dalaofei1154/codex-rotating-flower/hardware/README.md

# 雏菊模型与打印文件

一朵花需要 **10 个打印件**。这里提供 9 个 3MF 打印工程、13 个分色 STL 和 10 个可编辑 Blender 网格文件。

- [按图选择模型](daisy-light/VISUAL_GUIDE.md)
- [打印说明](daisy-light/README.md) · [English printing guide](daisy-light/README.en.md)
- [图解制作教程](../docs/diy-guide/README.md) · [English build guide](../docs/diy-guide/README.en.md)
- [零件与文件清单](daisy-light/manifest.json)

我现在的实物使用 L2 带灯盆盖和 P4 透明灯帽，转动、亮灯都正常。花心、灯帽和枝干与盆盖的连接还有些松，后续会继续改进；搬动时托住花盆。

模型采用 [CC BY-NC-SA 4.0](LICENSE.md)，可署名后非商业使用、修改，并以相同许可分享。
