dalaofei1154/codex-rotating-flower/hardware/daisy-light/README.md

# 雏菊带灯版 · 打印与可编辑模型

**简体中文** · [English](README.en.md) · [按图选择模型](VISUAL_GUIDE.md)

一套需要 **10 个打印件**，使用 L2 带灯旋扣盖和 P4 透明灯帽。文件包括 9 个 3MF 打印工程、13 个分色 STL 和 10 个 Blender 网格文件。

## 打印前

在 Bambu Studio 中选择“打开项目”，载入 `print/` 里的 3MF，再选择自己的打印机、喷嘴和耗材重新切片。检查逐层预览后打印。

- `P02.3mf` 含电机后盖和藏线盖，各用 1 件。
- `P06_2pcs.3mf` 含 2 个盆盖，一朵花只用 1 个。
- `P09_4pcs.3mf` 含 4 个灯帽，一朵花只用 1 个。

全部照原盘打印会得到 14 件，多出 1 个盆盖和 3 个灯帽。按需调整数量，保留原尺寸。3MF 中的料槽和颜色标签要按自己的耗材重新选择，灯帽使用透明 PLA。

使用双色 STL 时，把两份网格作为同一对象的多个部件导入，保留共同坐标；黑色描边与主体一起打印。

## 零件与打印设置

**PLA · 0.4 mm 喷嘴 · 0.20 mm 层高 · 单位 mm · 100% 比例**

下表颜色对应打印工程，可按喜好更换。我的成品用了红盆、米白花瓣和盆盖、绿枝叶、黄花心及黑描边。

| ID / 打印工程 | 成品与版本 | 一套数量 | 颜色 | 墙数 | 填充 |
| --- | --- | ---: | --- | ---: | ---: |
| P01 | B 枝干及两叶 | 1 | 绿＋黑 | 4 | 30% |
| P02 → P02A | 实心 3 号电机后盖 | 1 | 绿 | 4 | 100% |
| P02 → P02B | W1 7.1 mm 藏线盖 | 1 | 绿 | 4 | 100% |
| P03 | 约 120 mm 雏菊，盘厚 6 mm、黑边宽 1.6 mm | 1 | 白＋黑 | 4 | 35% |
| P04 | 2 号无三孔连接件，凸台 Ø16.95×4 mm，轴孔 5.1×3.1 mm | 1 | 米色 | 4 | 100% |
| P05 | P1 一体封底盆 | 1 | 米色 | 4 | 40% |
| P06_2pcs | L2 带灯短安装块旋扣盖，灯孔 Ø6.4 mm | 1 | 米色 | 6 | 40% |
| P07 | 完整电子托盘，四套环内径 6.75 mm | 1 | 米色 | 4 | 40% |
| P08 | Y1 最紧档 D22.00 花心 | 1 | 黄＋黑 | 4 | 100% |
| P09_4pcs | P4 灯帽：柱径 6.2 mm、柱长 6 mm、帽 Ø8×2.4 mm | 1 | 透明 PLA | 2 | 100% |

P04 和 P07 的孔位设有支撑屏蔽体，切片时保留。P06 正面朝下，去支撑时留意旋扣止退弹片。P09 帽面朝下、柱向上，无支撑，使用 2 mm brim。打印后先清除毛边，再试装。

## 装配

- 使用本套 P04 连接件和 P08 D22.00 花心。
- P06 的三处旋扣对齐盆体缺口放入，从上方看顺时针约 30° 到限位，反转打开。
- 我的花心、透明灯帽、枝干与盆盖连接处没有用胶，目前还有些松。逐处试装检查，搬动时托住花盆。
- 接好电路后先测试空轴，再装花盘测试低速及各档转动，最后整理线束、合盖复测。

完整步骤见[图解制作教程](../../docs/diy-guide/README.md)。

## 修改模型

`source/` 中的 Blender 文件按零件 ID 命名，P02 分为 P02A 和 P02B。可在 Blender 中编辑顶点和网格；这些文件没有参数化 CAD 的特征历史。部分零件保留装配坐标，打开后可能不在原点。打印时使用 `stl/` 或 `print/`，修改接口尺寸后先试装。

## 文件与许可

[manifest.json](manifest.json) 列出零件、规格与文件对应关系；[SHA256SUMS.txt](SHA256SUMS.txt) 可用于核对下载文件。

模型采用 [CC BY-NC-SA 4.0](../LICENSE.md)：署名、非商业使用，改编后以相同许可分享。
