dalaofei1154/codex-rotating-flower/docs/open-release/README.en.md

# Build a Rotating Flower

[简体中文](README.md) · [See it in action](../../README.md#watch)

Rotating Flower connects to your Mac over USB. The flower spins while your AI works and pulses a light when it needs your answer. Start here to build the daisy edition with a reminder light.

## Prepare and build

The listed materials total **CNY 53.92**: CNY 22.42 for electronics and wiring, plus CNY 31.50 for printing. Start with the [reference costs and parts list](../diy-guide/BOM.md#costs).

| Step | Guide |
| --- | --- |
| 1. Gather the parts | [Materials list](../diy-guide/BOM.md) |
| 2. Download and print | [Choose parts by picture](../../hardware/daisy-light/VISUAL_GUIDE.md) · [Printing guide](../diy-guide/PRINTING.md) |
| 3. Assemble and wire | [Illustrated build guide](../diy-guide/README.en.md) · [Wiring table](../diy-guide/WIRING.md) |
| 4. Flash the controller | [Motor and light firmware](../../firmware/README.md) |
| 5. Connect your Mac | [Install the software](INSTALL.md#en) · [Build checklist](../diy-guide/CHECKLIST.md) |

Each flower needs 10 printed parts. The models come as 3MF projects, color-separated STL files and editable Blender meshes. Some 3MF plates include spares; use the parts list to select one set and slice it for your printer.

The flower center, clear cap and stem-to-lid joint are fitted without glue and are still a little loose. Check these fits during assembly, and hold the pot when moving the flower.

## Software and source

The [v0.7.0 installer](https://github.com/dalaofei1154/rotating-flower/releases/tag/v0.7.0) supports Codex, WorkBuddy and DSH on Apple silicon Macs and includes Python. The bridge requires macOS 12+; DSH support requires macOS 13+. Open DSH once before installation and restart it afterwards. See the [installation guide](INSTALL.md#en) and [DSH notes](../dsh-macos.md#english).

[v0.7.0 software source](https://github.com/dalaofei1154/rotating-flower/tree/v0.7.0/m1) · [Firmware source](../../firmware/README.md) · [Editable models](../../hardware/daisy-light/README.en.md) · [Build updates](RELEASE_NOTES.md#english)

## Share your flower

Post a photo in [Issues](https://github.com/dalaofei1154/rotating-flower/issues), along with your printer, filament and anything you learned while building it. Fit improvements and bug reports are welcome too.

Software and firmware use MIT, written guides use CC BY 4.0, and models, photos and videos use CC BY-NC-SA 4.0. See the [license details](../../LICENSES.md) and [inspiration and credits](ATTRIBUTION.md).
