dalaofei1154/codex-rotating-flower/docs/从零搭建.md

# 从零制作旋转花

当前教程对应雏菊带灯版，从准备材料、打印零件，到装配、接线和安装软件。

- [图解制作教程](diy-guide/README.md)
- [模型重新设计说明（暂不提供下载）](../hardware/README.md)
- [接线说明](diy-guide/WIRING.md)
- [Mac 软件安装](open-release/INSTALL.md)

[项目首页](../README.zh-CN.md) · [English guide](diy-guide/README.en.md)
