dalaofei1154/codex-rotating-flower/docs/workbuddy-macos.md

# WorkBuddy Mac setup / WorkBuddy Mac 安装

WorkBuddy 使用小花的统一安装包，可单独使用，也可与 Codex 同时联动。

**[安装指南](open-release/INSTALL.md#zh)** · [功能与支持版本](../README.zh-CN.md#compatibility)

WorkBuddy uses the shared Rotating Flower installer. You can use it on its own or alongside Codex.

**[Installation guide](open-release/INSTALL.md#en)** · [Features and supported versions](../README.md#compatibility)
