dalaofei1154/codex-rotating-flower/docs/media/intro-en.jpg

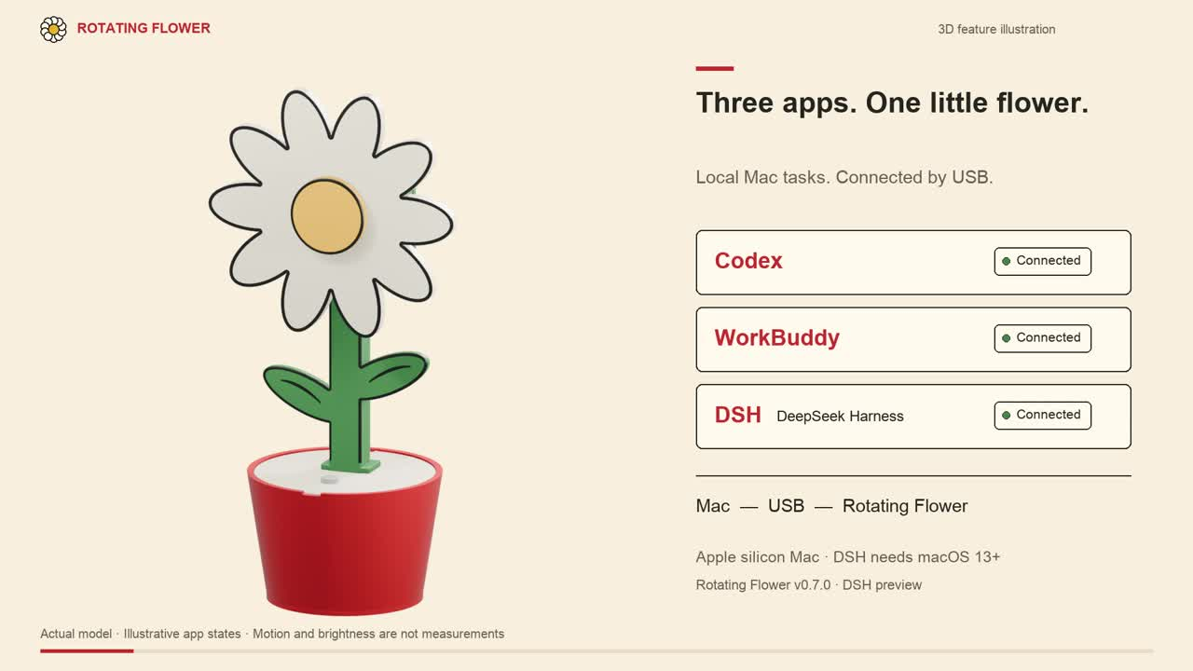
docs/media/intro-en.jpg
