dalaofei1154/codex-rotating-flower/publish-assets/demo-preview.gif

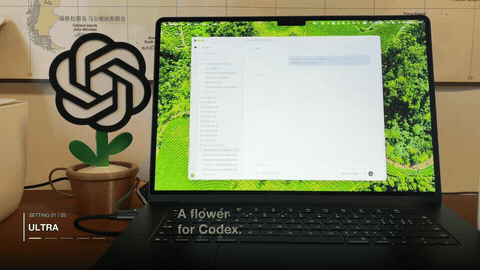
publish-assets/demo-preview.gif
