dalaofei1154/codex-rotating-flower/publish-assets/hardware-components-labeled.png

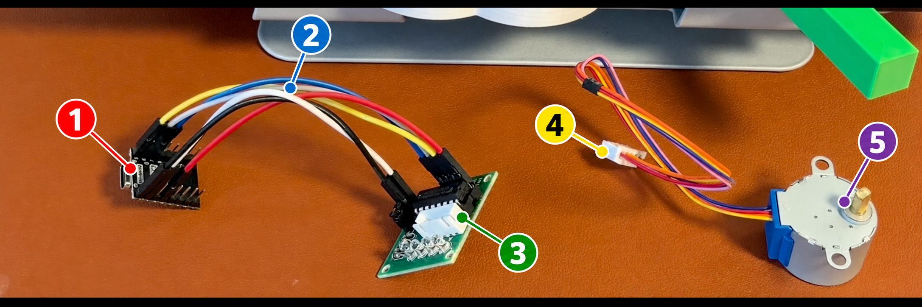
publish-assets/hardware-components-labeled.png
