dalaofei1154/codex-rotating-flower/publish-assets/optional-flower-parts-labeled.png

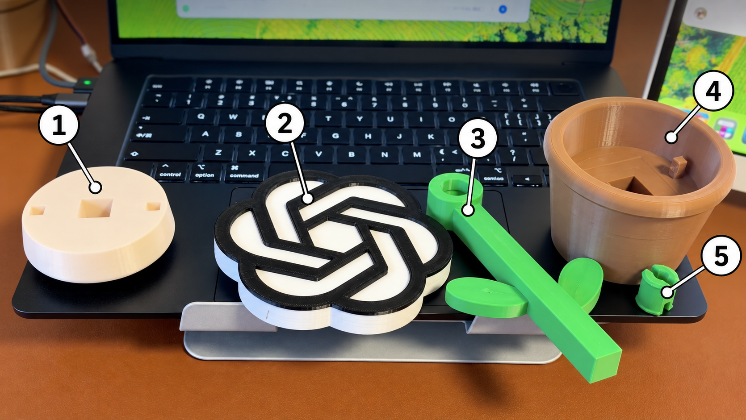
publish-assets/optional-flower-parts-labeled.png
