dalaofei1154/codex-rotating-flower/hardware/daisy-light/print/P09_4pcs.3mf

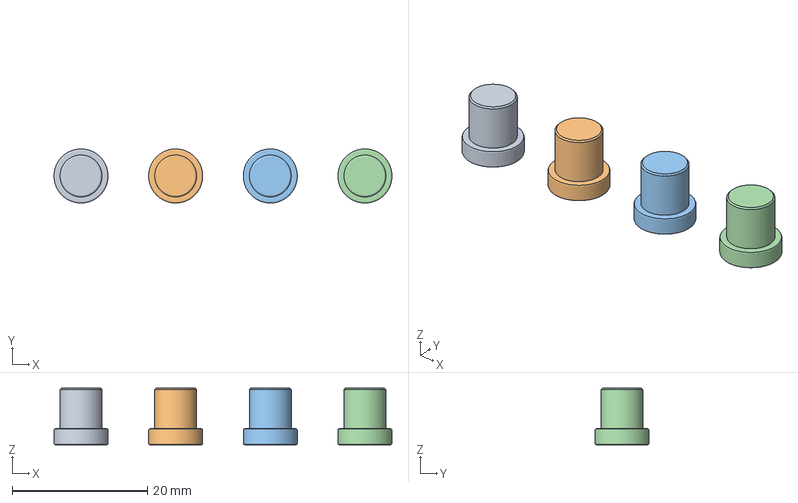
[picture p6: CAD file, 2026-11-06]
hardware/daisy-light/print/P09_4pcs.3mf
50.0 x 8.00 x 8.40 mm
1_D6p2
2_D6p2
3_D6p2
4_D6p2
