dalaofei1154/codex-rotating-flower/hardware/daisy-light/stl/P08_1.stl

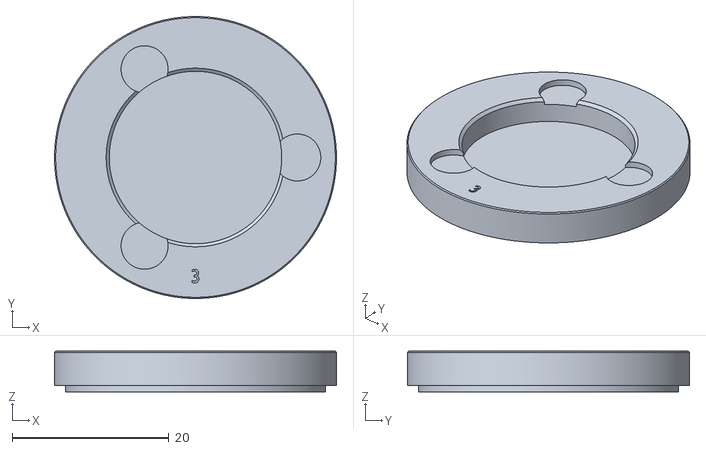
[picture p7: CAD file, 2026-11-06]
hardware/daisy-light/stl/P08_1.stl
36.0 x 36.0 x 5.20
