dalaofei1154/codex-rotating-flower/hardware/daisy-light/print/P05.3mf

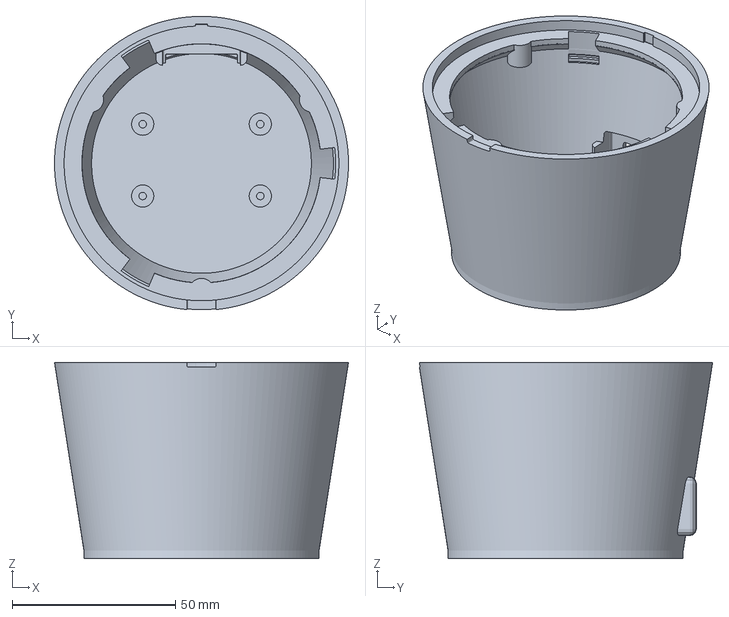
[picture p8: CAD file, 2026-11-06]
hardware/daisy-light/print/P05.3mf
90.0 x 89.8 x 60.0 mm
