dalaofei1154/codex-rotating-flower/hardware/daisy-light/stl/P03_1.stl

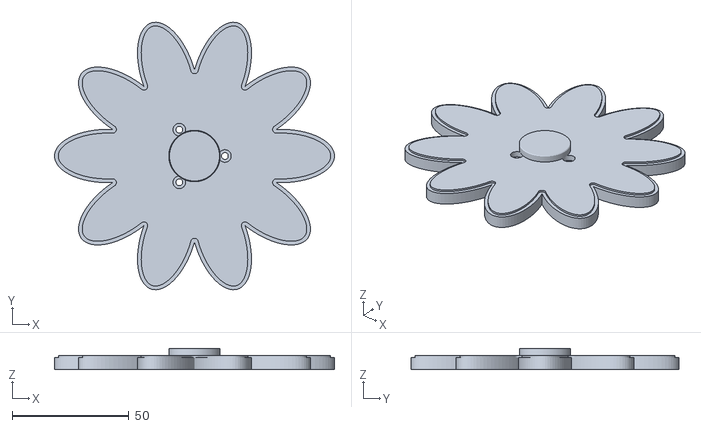
[picture p9: CAD file, 2026-11-06]
hardware/daisy-light/stl/P03_1.stl
119.9 x 114.5 x 9.00
