dalaofei1154/codex-rotating-flower/hardware/daisy-light/print/P02.3mf

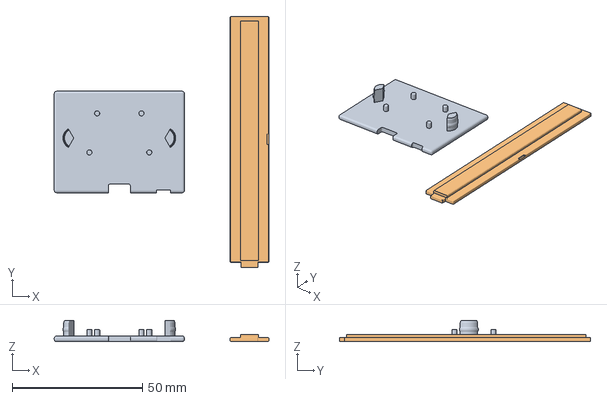
[picture p10: CAD file, 2026-11-06]
hardware/daisy-light/print/P02.3mf
82.4 x 96.4 x 8.20 mm
02_MOTOR_REAR_COVER_SOLID3
03_STEM_WIRE_COVER_W1_7p1
