dalaofei1154/codex-rotating-flower/hardware/daisy-light/stl/P01_2.stl

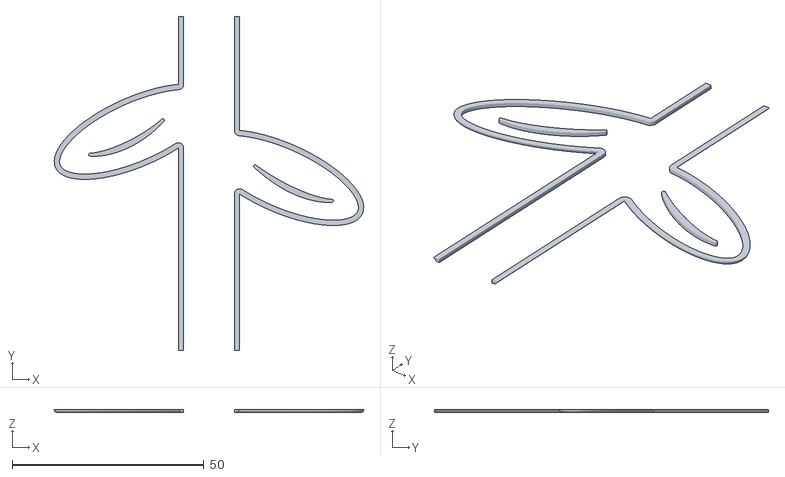
[picture p11: CAD file, 2026-11-06]
hardware/daisy-light/stl/P01_2.stl
80.6 x 87.0 x 0.8
