dalaofei1154/codex-rotating-flower/hardware/daisy-light/print/P03.3mf

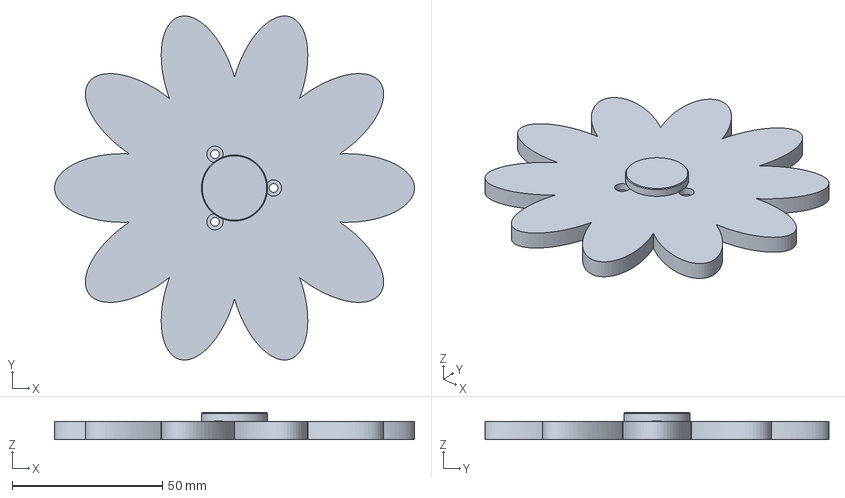
[picture p12: CAD file, 2026-11-06]
hardware/daisy-light/print/P03.3mf
119.9 x 114.5 x 9.00 mm
