dalaofei1154/codex-rotating-flower/hardware/daisy-light/stl/P08_2.stl

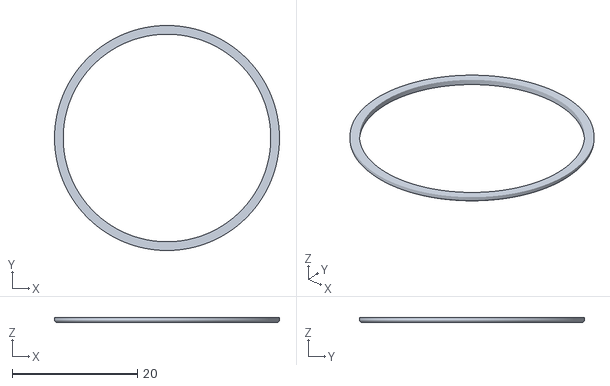
[picture p13: CAD file, 2026-11-06]
hardware/daisy-light/stl/P08_2.stl
36.0 x 36.0 x 0.8
