dalaofei1154/codex-rotating-flower/hardware/daisy-light/print/P01.3mf

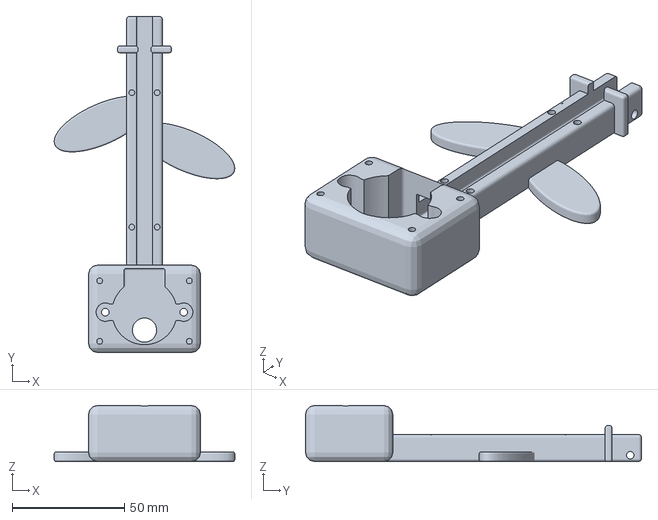
[picture p14: CAD file, 2026-11-06]
hardware/daisy-light/print/P01.3mf
80.6 x 150.0 x 25.0 mm
