dalaofei1154/codex-rotating-flower/hardware/daisy-light/stl/P09.stl

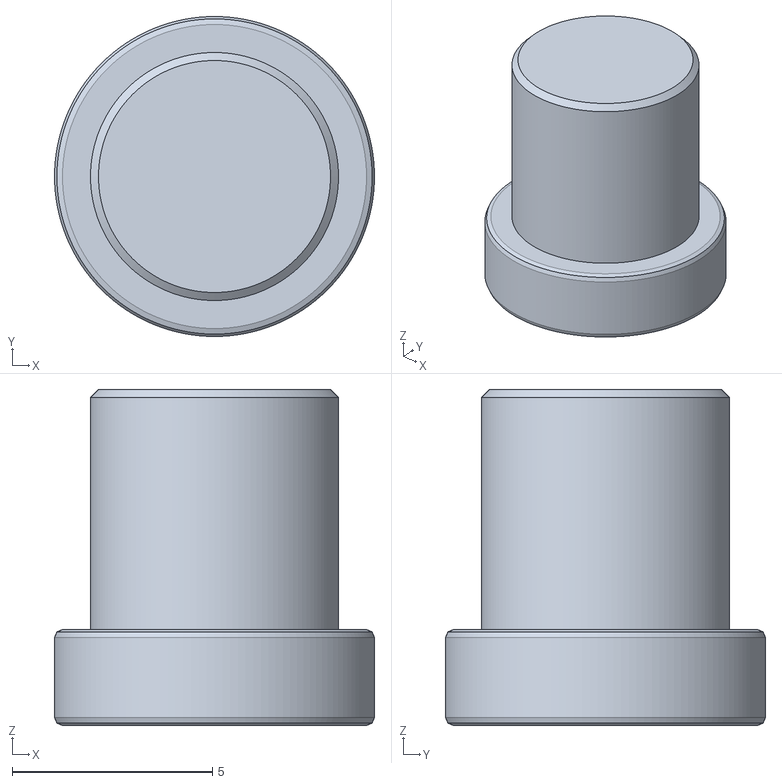
[picture p15: CAD file, 2026-11-06]
hardware/daisy-light/stl/P09.stl
8.00 x 8.00 x 8.40
