dalaofei1154/codex-rotating-flower/hardware/daisy-light/print/P04.3mf

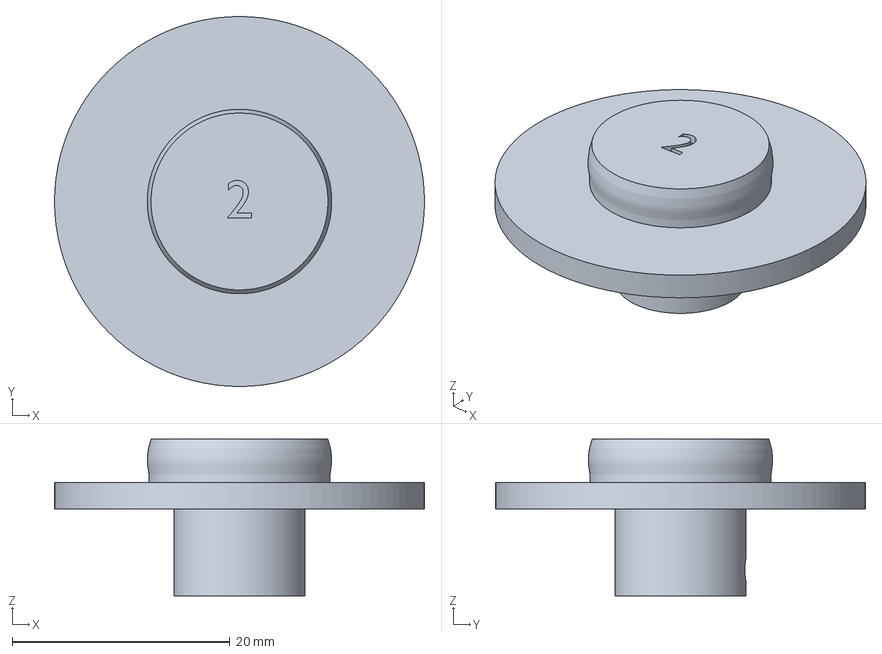
[picture p16: CAD file, 2026-11-06]
hardware/daisy-light/print/P04.3mf
34.0 x 34.0 x 14.4 mm
