dalaofei1154/codex-rotating-flower/hardware/daisy-light/stl/P02A.stl

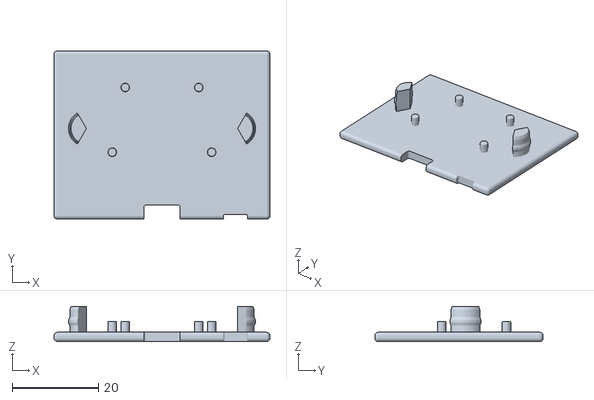
[picture p17: CAD file, 2026-11-06]
hardware/daisy-light/stl/P02A.stl
50.0 x 39.0 x 8.20
