dalaofei1154/codex-rotating-flower/hardware/daisy-light/print/P07.3mf

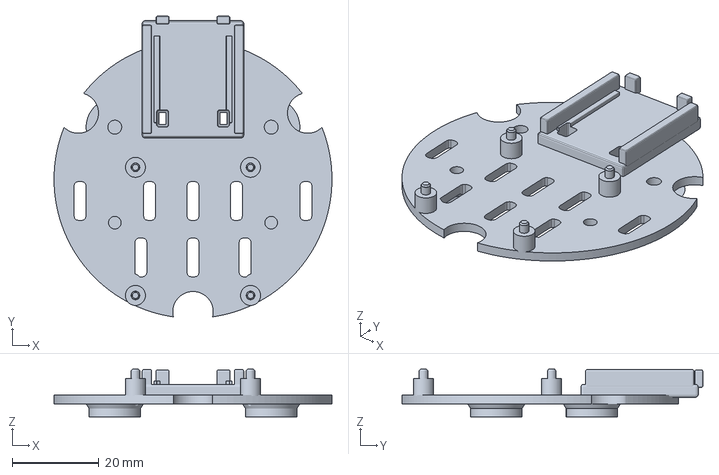
[picture p18: CAD file, 2026-11-06]
hardware/daisy-light/print/P07.3mf
64.0 x 69.2 x 11.0 mm
