dalaofei1154/codex-rotating-flower/hardware/daisy-light/stl/P01_1.stl

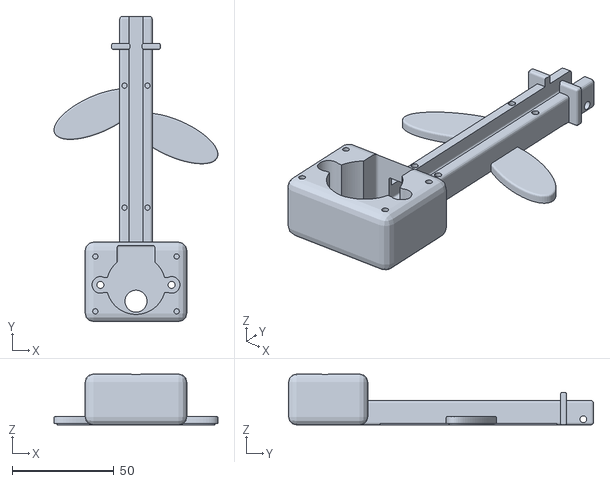
[picture p19: CAD file, 2026-11-06]
hardware/daisy-light/stl/P01_1.stl
80.6 x 150.0 x 25.0
