dalaofei1154/codex-rotating-flower/hardware/daisy-light/print/P06_2pcs.3mf

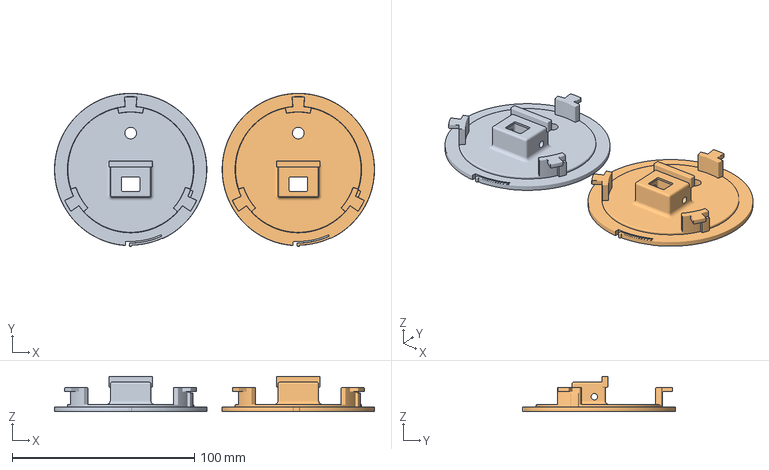
[picture p20: CAD file, 2026-11-06]
hardware/daisy-light/print/P06_2pcs.3mf
175.6 x 84.1 x 19.4 mm
L2_BEIGE_LID_SHORT_MOUNT
L2_BEIGE_LID_02
