dalaofei1154/codex-rotating-flower/hardware/daisy-light/stl/P02B.stl

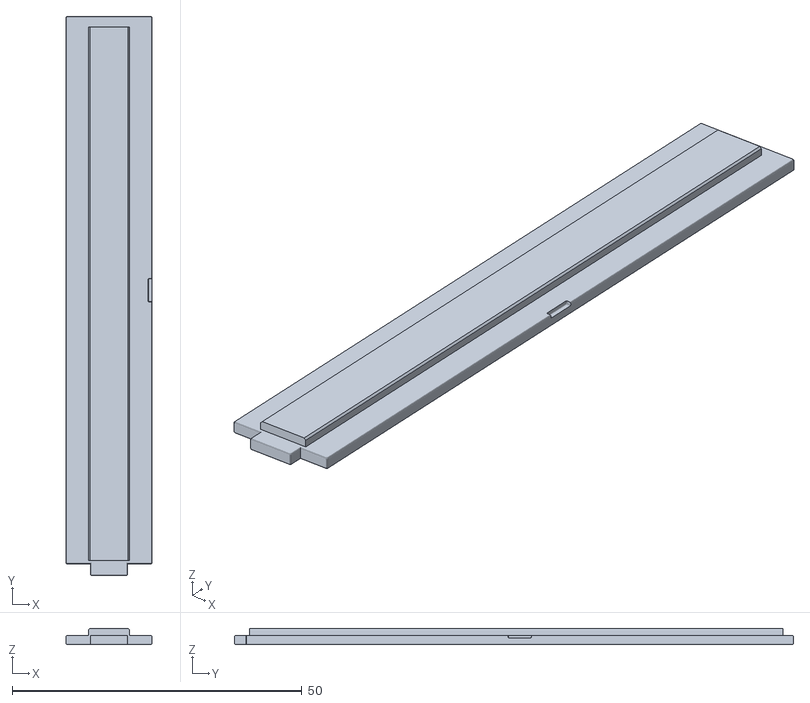
[picture p21: CAD file, 2026-11-06]
hardware/daisy-light/stl/P02B.stl
14.8 x 96.4 x 2.80
