dalaofei1154/codex-rotating-flower/hardware/daisy-light/print/P08.3mf

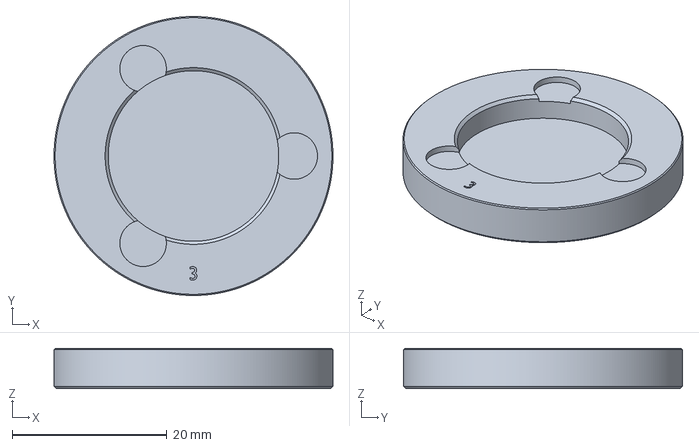
[picture p22: CAD file, 2026-11-06]
hardware/daisy-light/print/P08.3mf
36.0 x 36.0 x 5.20 mm
