dalaofei1154/codex-rotating-flower/hardware/daisy-light/stl/P06.stl

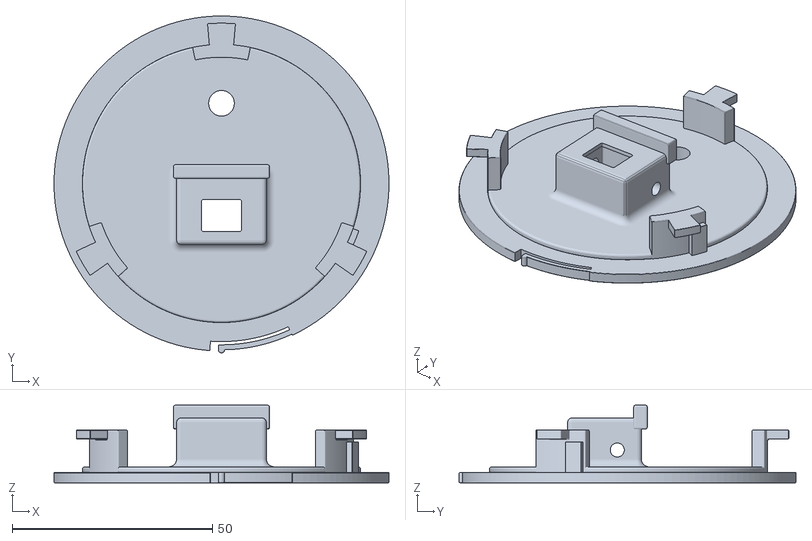
[picture p23: CAD file, 2026-11-06]
hardware/daisy-light/stl/P06.stl
83.6 x 84.1 x 19.4
