dalaofei1154/codex-rotating-flower/(list of files, cad)

Other CAD files:
hardware/daisy-light/source/P01.blend
hardware/daisy-light/source/P02A.blend
hardware/daisy-light/source/P02B.blend
hardware/daisy-light/source/P03.blend
hardware/daisy-light/source/P04.blend
hardware/daisy-light/source/P05.blend
hardware/daisy-light/source/P06.blend
hardware/daisy-light/source/P07.blend
hardware/daisy-light/source/P08.blend
hardware/daisy-light/source/P09.blend
hardware/daisy-light/stl/P04.stl
hardware/daisy-light/stl/P05.stl
hardware/daisy-light/stl/P07.stl
hardware/daisy-light/visuals/assembly-animation.blend
hardware/daisy-light/visuals/feature-effects.blend
