dalaofei1154/codex-rotating-flower/docs/build-guide-en.md

# Build a Rotating Flower

The current build guide covers the daisy edition, including printed parts, electronics, assembly and the rotation-and-light firmware.

- [Illustrated DIY guide](diy-guide/README.en.md)
- [Model redesign status (downloads paused)](../hardware/README.md)
- [Wiring](diy-guide/WIRING.md)
- [Mac installation](open-release/INSTALL.md#en)

[Project home](../README.md) · [中文教程](diy-guide/README.md)
