dalaofei1154/codex-rotating-flower/docs/diy-guide/REVIEW.md

# 旋转花教程发布前补充清单

这是作者复核页，配合 [中文制造与装配教程](README.md) 和 [English guide](README.en.md) 使用。本轮更新依据既有文件、制作聊天及作者 2026-11-05 的补充确认；未完成项目不计为通过。

## 已经确认

2026-11-05，作者在本次整理中确认：

- 电路板与电子托盘、灯板与安装台、电机与安装腔使用热熔胶加固。
- 花盘背面的传动连接件采用卡入配合，也可以用热熔胶加固。
- 驱动板上的黑色片和绿色胶带用于遮挡指示灯，避免干扰灯板的提醒效果。
- 主体打印材料为 PLA；电机沿用 1:16 减速比；杜邦线为 10 cm 母对母。
- 正式选择模型 **CC BY-NC-SA 4.0**；这批 DIY 照片和替换背景成品图也为 **CC BY-NC-SA 4.0**。商业使用需作者另行授权。
- 作者在本次整理中明确确认 **L2＋P4 已装好，转动和亮灯都正常**。
- 作者随后确认花心、透明灯帽、枝干与盆盖连接处均未用胶，目前连接不够稳固，后续拟通过模型迭代改善。功能正常与保持力可靠分别记录；本版不将这三处写为稳固验收通过。
- P4 灯帽打印记录为透明 PLA，D6.2；其几何复用已被接受的 P3 第1档。
- 作者已补充灯板商品图：KY-016，四根预焊直角公排针沿 PCB 板边平行伸出，可见三颗电阻和 R/G/B/− 丝印。排针采购形态已确认；共阴规格沿用项目既有要求，不把商品图视为新增电气实测。
- 成品照允许替换背景，已生成暖灰背景展示图；原照片保留在原始文件夹及本地审阅目录。

## 后续提供记录时补齐

| 项目 | 需要补的内容 | 影响 |
| --- | --- | --- |
| 已知配合问题 | 后续迭代花心、透明灯帽、枝干与盆盖的接口，并记录修改后的保持力 | 当前三处均未用胶且不够稳固，不把补胶当成已验证解决方案 |
| 电机采购记录 | 5 V、1:16 的可核对规格或铭牌 | 现有材料与作者确认已足够写入教程；采购记录有助他人避免买错版本 |
| 地线采购记录 | 一分二线实购接头、总长度或型号 | 已给出 8 根母对母＋1 组三母口分线的电气拓扑，供应商料号可后补 |
| 独立复现 | 不同打印机的整套打印与另一台 Mac 首次安装 | 不能把作者本机与实装结果等同所有环境验证 |
| 持续运行 | 长时间温升、噪声、耐久；改进接口后的保持力复测 | 当前已知连接不稳与长期未测是两项不同问题，不以短时功能通过代替 |
| 软件场景 | 实际系统审批弹窗、应用升级后复测 | 问题卡实测不能代替所有审批弹窗；应用本地格式会变化 |

如后续方便补图，最有用的是：托盘最终入盆与 USB 对位、盖内线束收纳、第一次转动和亮灯测试。这些补图有助于理解，但现有教程已提供相应文字步骤。

## 图片与目录说明

- `README.md` / `README.en.md`：中文与英文装配、固件及安装教程。
- `BOM.md` / `PRINTING.md` / `WIRING.md` / `CHECKLIST.md`：双语采购、打印、接线与验收速查。
- `images/`：精选 15 张装配 JPEG，以及 1 张替换背景后的成品 PNG。图片相对路径可随文件夹一起迁移。
- `PHOTO_INDEX.md`：全部 22 张原图的用途与选用记录。
- 成品 PNG 使用内置 image_gen 编辑，由 IMG_2577 派生；只作为成品展示。安装位置、接线和配合仍以实拍过程图为准。
- 全部原图的 HEIC 文件未覆盖；JPEG 副本已移除 EXIF 元数据。未选用的重复图和带屏幕背景的原图不放入这一候选发布目录。
- 后补的 KY-016 商品图仅用于核对模块规格，没有复制到公开 `images/`，也不加入作者 DIY 图片的再分发许可范围。

模型与图片的具体许可分别见 [模型许可](../../hardware/LICENSE.md) 和 [图片许可](images/LICENSE.md)。代码与文字沿用各自原有许可，见 [LICENSES.md](../../LICENSES.md)。资料整理完成不代表这些新模型已经上传到公开站点。

## 核对依据与版本边界

- [正式组合固件副本](../../firmware/flower_integrated/flower_integrated.ino) 与既有烧录记录中的源码一致；GPIO0/1/3 控制 RGB，GPIO4/5/6/7 控制电机。旧纯旋转固件不用于本教程。
- [模型文件与清单](../../hardware/README.md) 将 L2 带灯盖替换旧无灯盖，并加入 P4 透明帽；分色部件合计为 10 件成品。
- [打印说明](PRINTING.md) 的原始参数来自 10 月 31 日商家包、L2 模型说明及 P4 工程设置；未把打印发送记录写成打印完成证据。
- L2＋P4 工作状态依据作者在本次整理中的直接确认；五档和超时实测另有 2026-11-05 新设备串口记录。它们分别支持装配与功能结论。
- [v0.6.0 安装说明](https://github.com/dalaofei1154/rotating-flower/blob/v0.6.0/docs/install-macos.md) 与 [公开 Release](https://github.com/dalaofei1154/rotating-flower/releases/tag/v0.6.0) 是固定软件版本入口；本地开发分支的后续功能不自动包含在 v0.6.0 中。
- Arduino-ESP32 3.3.11 及 USB CDC、DIO、115200 设置依据历史实际构建记录；本轮文档整理没有重新烧录设备。

[验收表](CHECKLIST.md) 区分作者已有记录与读者每台成品的实际自测，不预先替读者填写通过。
