dalaofei1154/codex-rotating-flower/docs/diy-guide/PHOTO_INDEX.md

# DIY 过程照片索引

共 22 张 HEIC 原图，编号 IMG_2556 至 IMG_2577。正文按装配依赖编排，文件编号不等于操作顺序。每个文件只承担它实际展示的内容。

| 原图 | 内容 | 采用情况 |
| --- | --- | --- |
| IMG_2556.HEIC | 全部零件平铺 | 图 1，材料总览 |
| IMG_2557.HEIC | 零件平铺近似画面 | 重复备选，未放入发布目录 |
| IMG_2558.HEIC | 热熔胶固定电子板 | 图 2，步骤 1 |
| IMG_2559.HEIC | 电机入腔及背面走线 | 图 3，步骤 2 |
| IMG_2560.HEIC | 电机入腔及走线近似画面 | 重复备选 |
| IMG_2561.HEIC | 灯板背面安装位置 | 图 5，步骤 3 |
| IMG_2562.HEIC | 盆盖正面的灯帽 | 图 6，步骤 3 |
| IMG_2563.HEIC | 电机后盖与藏线盖完成 | 图 4，步骤 2 |
| IMG_2564.HEIC | 花盘正面花心 | 图 7，步骤 4 |
| IMG_2565.HEIC | 花盘背面传动连接件 | 图 8，步骤 4 |
| IMG_2566.HEIC | 电路整体连接展示 | 图 11，步骤 6；实操应先穿盖再接电机 |
| IMG_2567.HEIC | 整体接线近似画面 | 重复备选 |
| IMG_2568.HEIC | 托盘底面与盆内定位柱 | 图 14，步骤 8 |
| IMG_2569.HEIC | 遮光片摆放 | 图 12，步骤 7 |
| IMG_2570.HEIC | 遮光片中间状态 | 备选；正文用初始与最终状态 |
| IMG_2571.HEIC | 遮光片用胶带固定 | 图 13，步骤 7 |
| IMG_2572.HEIC | 电机线从盆盖正面穿入 | 图 9，步骤 5 |
| IMG_2573.HEIC | 盆盖背面穿出的插头 | 图 10，步骤 5 |
| IMG_2574.HEIC | 插头穿盖近似画面 | 重复备选 |
| IMG_2575.HEIC | 枝干插入盆盖、盆体合拢 | 本地参考，背景有屏幕；正文以文字说明，不加入发布目录 |
| IMG_2576.HEIC | 电机轴与连接件对位 | 图 15，步骤 9 |
| IMG_2577.HEIC | 完整成品正面 | 用作背景替换输入；原图含屏幕背景，不加入发布目录 |

## 转换与编辑记录

装配图由 HEIC 解码为 JPEG，长边 1800 px，保留完整画面与方向；无生成式修改，无局部替换。导出 JPEG 不携带原图 EXIF。

成品图输出为 `images/finished-clean-background.png`：由内置 image_gen 将 IMG_2577 的电脑、桌面杂物背景替换成暖灰色桌面与浅灰背景。提示词要求保留实物的花瓣、花心、枝叶、盆盖、透明灯帽、红色花盆和打印纹理。该图用于封面与成品展示，不作为尺寸或装配配合依据。

原始 22 张 HEIC 仍在作者提供的文件夹内，所有原图转换副本及完整编辑提示词在本地审阅目录中保留。候选发布目录仅收录正文使用的图片。
