dalaofei1154/codex-rotating-flower/debug_log.md

# Prototype test notes / 原型测试记录

**English summary:** The ESP32-C3, ULN2003, and 5 V 28BYJ-48 motor responded to serial commands in short bench tests. The Mac bridge also changed the motor among LOW, MEDIUM, HIGH, XHIGH, and ULTRA during local Codex tasks, then stopped it when tasks ended. The current build uses an approximately 1:16 geared motor. LOW and MEDIUM looked similar by eye; the higher settings looked progressively faster. Speed figures below are estimates from programmed step timing, **not measured output RPM**. Continuous operation, other motors, and other loads have not been fully tested. The dated record below is in Chinese.

目标：Mac 通过 USB 控制 ESP32，使步进电机稳定启动、停止，并呈现三种明显不同的转速。

## 已确认器件

- 电脑：MacBook Air M5
- 开发板：ESP32-C3 SuperMini
- 电机：28BYJ-48，铭牌标注 5 VDC，五线插头
- 驱动板：ULN2003APG 芯片，板上有五针电机插座、IN1–IN7 输入和标注 5–12 V 的双针电源接口
- 连接线：USB-C 数据线 1 根；照片可见约 6 根两端为母头的杜邦线，可用于两块板子的公排针
- 电源：当前由 Mac USB 供电，ESP32-C3 开发板标注的 5V/G 引脚连接驱动板电源。另有 USB 充电头或充电宝，但没有接线转接头。

## 当前状态

- 用户确认接线按要求完成，串口控制与带 Logo 转动已验证。
- 已实现五档 Codex 推理强度映射；最高档 Ultra 为 2 ms/步，约 14.6 rpm 目标轴速，已通过短时稳定性测试和自动联动实测。
- 转速按约 2048 步/输出轴圈估算，未经独立测速；尚未测得绝对最高转速。

## 测试记录

### 2026-09-23

- USB 识别：通过。Mac 系统信息显示 Espressif USB JTAG/serial debug unit，串口为 `/dev/cu.usbmodem101`；开发板电源灯亮。
- 开发环境：本机已安装 Arduino IDE 和 ESP32 Arduino Core 3.3.11。
- 运行代码：通过。已编译并上传 `m0/usb_smoke_test/usb_smoke_test.ino`；芯片识别为 ESP32-C3、4 MB flash，写入校验通过。
- 双向串口：通过。监视器收到 `M0 READY` 和周期性 `M0 ALIVE`；发送 `PING` 后收到 `PONG`。
- 驱动板与电机：本次未通电测试。查阅此前豆包对话，用户曾在接入驱动板与电机后报告电机发烫、USB 串口反复出现和消失；当时的实际接线与电压未独立核对，故障原因仍未确认。
- 后续实物照片：确认电机铭牌为 28BYJ-48 5 VDC；驱动板正反面和 ESP32 开发板正反面已拍到。用户明确表示所有器件已断电并分开。
- 电机已在断电状态插入驱动板五针插座；其余连接线仍未接入。
- 已编译并上传限时单线圈测试固件 `m0/motor_test/motor_test.ino`；默认全部线圈关闭，收到 `TEST` 才运行约 1.5 秒并自动关断。写入及校验通过，复位后串口仍在线。
- 首次发送 `PING` 和 `TEST`，串口依次收到 `PONG`、`TEST START`、`TEST DONE`。等待用户确认电机轴的实际运动。
- 用户确认 `TEST` 时电机轴按固定角度逆时针转动三次，符合 256 步短测预期。
- 已编译并上传 `m0/motor_control/motor_control.ino`，支持 `RUN LOW`、`RUN MEDIUM`、`RUN HIGH`、`STOP`；各档持续转动、串口回复正常。最初 10/6/4 ms 速度差不明显，现改为 25/10/4 ms。
- 用户以轴端标记观察，15 秒内 HIGH 实际转过的角度明显多于 LOW。Logo 固定后短测仍能收到三档及 STOP 回复，但肉眼只分辨出两档；OpenAI Logo 的重复图案可能影响观察。
- 已在 Logo 外缘加临时标记，按 LOW、MEDIUM、HIGH 各独立运行 15 秒并分别停止；三次串口均返回 `RUNNING …` 和 `STOPPED`。用户观察到 LOW 约 100°、MEDIUM 约 220°、HIGH 超过一圈半，实际速度逐级增加。
- Logo 固定后重新做了短时三档测试，串口仍稳定在线，三档及 STOP 均有回复。
- 已启动 `m0/codex_bridge.py`：读取当前本地 Codex 任务记录中的推理强度及开始／结束事件，映射到电机串口命令。当前任务为 `xhigh`，桥接器发送 `RUN HIGH`，用户确认 Logo 正在持续转动。任务结束事件触发的自动 STOP 尚待实测确认。
- 下一轮用户切换为 Codex `low` 并发送“低档测试”：桥接器日志显示前一轮结束时发送 `STOP`，本轮设置更新为 `low` 后发送 `RUN LOW`；用户确认 Logo 明显以低速旋转。自动低档映射及结束事件对应的 STOP 命令已验证。
- 用户切换为 Codex `medium` 并发送“中档测试”：桥接器读取到本轮 `medium` 并发送 `RUN MEDIUM`；用户确认 Logo 明显是中档速度。至此，当前任务的 HIGH（`xhigh`）、LOW、MEDIUM 及轮次结束 STOP 联动均有实际验证。
- 用户提出五档映射，确认希望 HIGH→XHIGH→ULTRA 每档目标转速翻倍。旧版 `xhigh`、`ultra` 共享 HIGH 转速，因此已增加独立命令和映射。
- 带 Logo 实测：2 ms/步能连续转且明显快于原 HIGH；1 ms/步从启动测试中抖动、停转；减缓加速后，1 ms/步仍在后段失步；1.5 ms/步约 3 秒后失步并伴随震动。
- 最终目标步进间隔：LOW 32 ms、MEDIUM 16 ms、HIGH 8 ms、XHIGH 4 ms、ULTRA 2 ms；目标轴速约 0.9、1.8、3.7、7.3、14.6 rpm（按约 2048 步/轴转估算）。固件加了加速过程，不能把这些目标值视为实际测速结果。
- 新版 Ultra（2 ms/步）带 Logo 连续运行 20 秒，用户确认全程稳定。五档 `codex_bridge.py` 的命令映射和 STOP 已通过逻辑测试；联动桥重新启动后读到当前 `high` 并发送 `RUN HIGH`。本套装配已验证的最高目标速度约 15 rpm；电机绝对最高转速未测得。
- 用户明确 M0 顺序：先接硬件，再运行简单程序让电机动起来，最后才映射 Codex 推理强度与转速。可接受电机约 40–50°C 的温度。
- 已从照片确认：电机 28BYJ-48 5 VDC；ESP32-C3 SuperMini 背面标注 5V/G、GPIO4/5/6/7；驱动板有 IN1–IN4 和标注正负极的双针电源接口；照片中的杜邦线为母对母。
- 当前接线：ESP32 5V→驱动板 +，G→-，GPIO4/5/6/7→IN1/2/3/4；电机五针插头→驱动板五针插座。
- 本轮用户发送“ultra 测试”：桥接器快照读到 `ultra`，运行日志确认自动发送 `RUN ULTRA`；用户确认“是，最快档且稳定”。Ultra 自动联动实测通过。
- 规格解释：通用 28BYJ-48 资料中的空载牵出频率 >1000 Hz 是性能指标的下限，不能视作最大频率上限；原单页未注明励磁序列，不能直接套用当前四状态驱动来宣称最高 RPM。当前 2/1.5/1 ms 对应的约 14.6/19.5/29.3 rpm 均为程序目标值，后两者已在本装配测试中失步。

## M1：跨 Codex 任务联动（2026-09-23）

- 原 `m0/codex_bridge.py` 只读取一个指定任务文件，且串口号写死为 `/dev/cu.usbmodem101`，因此无法覆盖新开的 Codex 任务；Mac 后来将开发板枚举为 `/dev/cu.usbmodem1201`。
- 已增加 `m1/global_bridge.py`：自动发现本机所有 Codex 主任务；同一时间有多个任务运行时，采用最高推理强度；所有任务结束时发送 `STOP`。忽略子代理的转录副本，避免重复计数。
- 自动搜索 USB 串口并以 `PING`/`PONG` 确认 ESP32。实际运行时找到了 `/dev/cu.usbmodem1201` 并发送 `RUN ULTRA`；另一真实 Codex 主任务同时运行时也被发现，日志显示 2 个活跃任务。
- `m1/test_global_bridge.py` 的 4 项逻辑测试通过，包括新任务发现、最高档仲裁、任务结束回退、中断、子代理过滤、陈旧任务失效与串口变号。
- 已用 `m1/install_macos.py` 安装用户级 LaunchAgent `com.rotatingflower.codex-motor`。`launchctl` 显示服务运行中；服务日志再次确认连接 ESP32 并发送 `RUN ULTRA`，错误日志为空。此服务在 Mac 登录后自动启动，不依赖本任务窗口。
- 解析 Codex 本地任务记录使用内部格式；Codex 升级后需要复测。当前已在本机实际记录中核对 `task_started`、`turn_context.effort`、`task_complete` 的事件顺序。完整跨窗口物理观测仍以用户确认及后续新任务测试为准。

## 23 cm 手动模型与新电机测速（2026-09-27）

- 用户用双面胶和透明胶带把电机机身临时固定到手动版模型的绿色把柄；新电机照片铭牌为 28BYJ-48、5 VDC、1:16。用户确认整套模型在原有 ULTRA（2.0 ms/步）档平稳转动。
- 在 `m0/motor_control/motor_control.ino` 增加限时速度测试命令；测试期间暂停自动桥接器，发送命令并等待固件自动停止，随后恢复桥接器。编译、上传、串口 `PING`/`PONG` 和限时停止均通过。
- 1.5 ms/步：5 秒短测未看清；20 秒测试时用户观察到先明显加快，几秒后停转并抖动。胶带和电机机身没有移位，表现符合失步。
- 1.8 ms/步：20 秒内用户观察到约 90% 时间平稳，但有约 1 秒停顿后恢复；判为边缘不稳定。
- 1.9 ms/步：20 秒内用户观察到全程平稳，是当前装配**已短时验证**的最快档；长期稳定性未测。
- 日常桥接器的 ULTRA 仍为 2.0 ms/步，避免把边缘速度设成长期运行档。测试结束后已确认 LaunchAgent 恢复运行并重新连接 `/dev/cu.usbmodem1201`。
- 若按该类 1:16 电机约 512 个四状态全步/输出圈粗算，2.0/1.9/1.8/1.5 ms 的目标输出转速分别约为 59/62/65/78 rpm；这些是命令值换算，未进行独立实测。
- 照片里绑在把柄上的电机与手持电机铭牌均可辨为约 `5VDC 1:16`。先前旧电机约 14.6 rpm 的数字是按约 2048 步/圈推算，旧电机的实际减速比和转速都未核对；因此目前不能把“比旧电机快四倍”当作实测结论。

## 第三颗电机试转（2026-09-27）

- 用户随后提供另一颗较贵电机的清晰照片，铭牌为 `28BYJ-48 5VDC 1/32 20Ω`，接在白色花瓣上。它与上一颗 1:16 电机不是同减速比；在同样四状态步进间隔下，其输出轴目标转速约为 1:16 电机的一半（不同花瓣负载下不可直接当作实际速度对比）。
- 用户已将第三颗电机接入驱动板并确认能转，但肉眼感觉明显比第二颗 1:16 电机慢，优点是声音较小。
- 自动桥接器暂停期间，第三颗电机在 `RUN ULTRA`（2.0 ms/步）独立运行 20 秒，用户确认全程平稳。
- `TEST FAST20`（1.5 ms/步）固件和串口都运行满 20 秒，但用户观察到花瓣仅动了不到一秒，随后不再转动。固件无失步检测，串口完成消息不能证明电机实际旋转。
- `TEST 1800`（1.8 ms/步）重复两次、每次命令持续 20 秒；用户最终确认未持续转满，认为除安静外效果一般。测试没有支持把更短的间隔设成常用档。
- 曾在源码中准备 1.2/1.0 ms 测试命令，但未上传、未执行；因 1.8 ms 尚不稳定，已从源码撤回。正常 ULTRA 仍为 2.0 ms/步。
- 用户换回最早带 Logo 的原电机，在桥接器暂停期间以同样 `RUN ULTRA`（2.0 ms/步）独立运行 20 秒；串口返回正常。用户肉眼确认原电机比第三颗较贵的 1/32 电机还慢，并认为第二颗便宜的 1:16 电机最适合当前速度目标。这是不同装配的主观速度比较，未做独立 RPM 测量。
- 用户随后把第二颗 1:16 电机重新接上 USB；已恢复 `com.rotatingflower.codex-motor` LaunchAgent，状态为 running，日志确认重连 `/dev/cu.usbmodem1201` 并发送 `RUN ULTRA`。最高常用档仍为 2.0 ms/步。
- 第二颗 1:16 电机的自动档位复测：用户手动将 Codex 推理强度依次设为 LOW、MEDIUM、HIGH；桥接器日志分别确认 `RUN LOW`、`RUN MEDIUM`、`RUN HIGH`。用户观察 LOW 和 MEDIUM 均持续转动但速度差异不明显；HIGH 持续平稳转动且明显快于 MEDIUM。
- 用户切换 XHIGH，桥接器日志确认 `RUN XHIGH`；第二颗 1:16 电机持续平稳转动，肉眼明显快于 HIGH。
- 用户切换 ULTRA，桥接器日志确认 `RUN ULTRA`；第二颗 1:16 电机持续平稳转动，肉眼明显快于 XHIGH。至此 LOW、MEDIUM、HIGH、XHIGH、ULTRA 五档自动联动均完成当前电机装配的复测；LOW 与 MEDIUM 的肉眼差异不明显，其余相邻高档差异明显。
- 用户补充三种电机的主观体验和购入信息：1:16 速度满意、稍有声音，现有 3 个、单价 3 元；1:32 速度不理想、几乎无明显声音，现有 1 个、单价 15 元；1:64 速度最慢、仅有轻微声音，在非完全安静环境里基本听不到，单价 8 元。按目前“旋转花需要明显速度变化”的目标，1:16 是现有三种里的首选；这是基于当前装配体验，不是统一条件下的噪声或 RPM 仪器测量。
