dalaofei1154/codex-rotating-flower/(commit log)

2026-09-29 Add ESP32 motor firmware
2026-09-29 Add motor test sketch
2026-11-01 Document WorkBuddy release and rename project to Rotating Flower
2026-11-04 Release v0.6.0 unified Mac installer (#2)
    * Add unified rotation and attention bridge
    * Add unified Mac installer and pinned download
    * Document simple unified Mac installation
    * Publish combined motor and attention firmware
    * Document unified installer v0.6.0 release
2026-11-06 Publish bilingual flower guides and music videos
2026-11-06 Focus public materials on the flower and how to build it
2026-11-06 Feature approved live demo and publish material costs
2026-11-12 Withdraw daisy v1 models while the visible design is redrawn
    The stem, leaves and pot proportions of daisy v1 followed a
    third-party ornament too closely. Stop distributing them from the
    current tree; history and tags are unchanged. Software, firmware
    and guides are unaffected.
